dragonplus-electronics/Atom-Iss5-V001/KiCad/Power.kicad_sch

## KiCad design KiCad/Power.kicad_sch (2024-11-30)

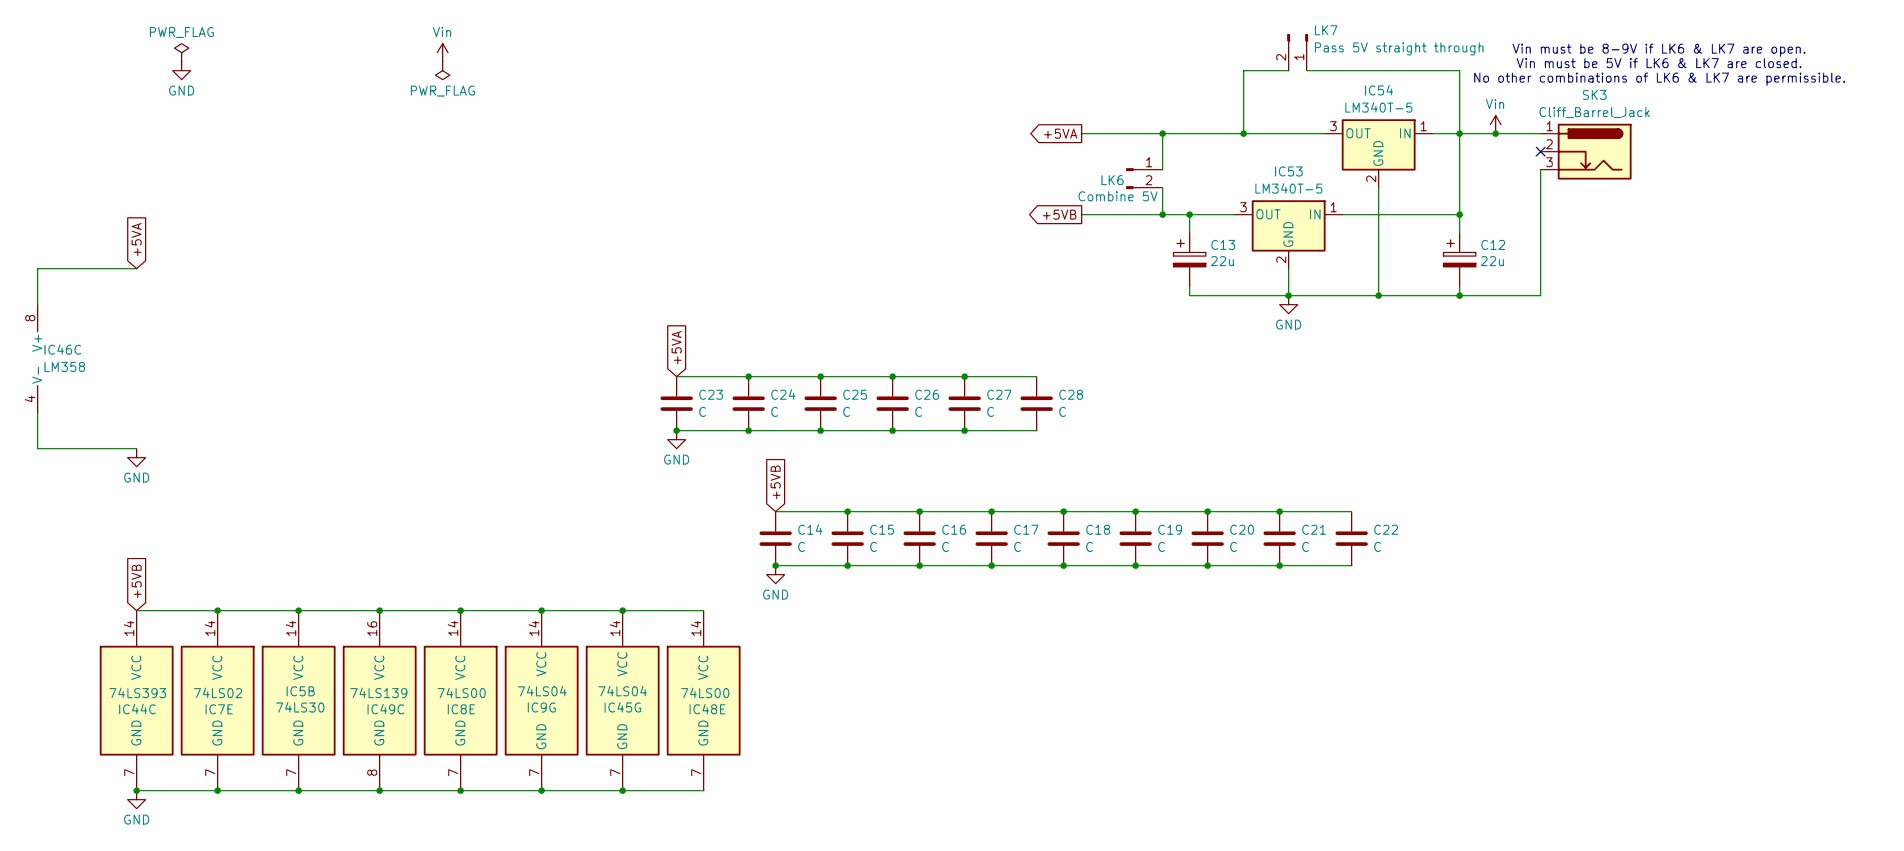
[picture p4: schematic Power.kicad_sch]

Parts:
C12: 22u; CP_Axial_LineOnly_P17.78mm_Horizontal
C13: 22u; CP_Axial_LineOnly_P19.05mm_Horizontal
C14, C15, C16, C17, C18, C19, C20, C21, C22, C23, C24, C25, C26, C27, C28: C; C_Disc_LineOnly_P5.08mm
IC5: 74LS30; DIP-14_W7.62mm_InnerMarking
IC7: 74LS02; DIP-14_W7.62mm_InnerMarking
IC8, IC48: 74LS00; DIP-14_W7.62mm_InnerMarking
IC9, IC45: 74LS04; DIP-14_W7.62mm_InnerMarking
IC44: 74LS393; DIP-14_W7.62mm_InnerMarking
IC46: LM358; DIP-8_W7.62mm_InnerMarking
IC49: 74LS139; DIP-16_W7.62mm_InnerMarking
IC53, IC54: LM340T-5; TO-220-3_Horizontal_TabDown
LK6: Combine 5V; PinHeader_1x02_P2.54mm_Vertical
LK7: Pass 5V straight through; PinHeader_1x02_P2.54mm_Vertical
SK3: Cliff_Barrel_Jack; Cliff_FC681461_Barrel_Jack

Connections:
+5VA: C23.1, C24.1, C25.1, C26.1, C27.1, C28.1, IC46.8 (V+), IC54.3 (OUT), LK6.1, LK7.2
+5VB: C13.1, C14.1, C15.1, C16.1, C17.1, C18.1, C19.1, C20.1, C21.1, C22.1, IC5.14 (VCC), IC7.14 (VCC), IC8.14 (VCC), IC9.14 (VCC), IC44.14 (VCC), IC45.14 (VCC), IC48.14 (VCC), IC49.16 (VCC), IC53.3 (OUT), LK6.2
GND: C12.2, C13.2, C14.2, C15.2, C16.2, C17.2, C18.2, C19.2, C20.2, C21.2, C22.2, C23.2, C24.2, C25.2, C26.2, C27.2, C28.2, IC5.7 (GND), IC7.7 (GND), IC8.7 (GND), IC9.7 (GND), IC44.7 (GND), IC45.7 (GND), IC46.4 (V-), IC48.7 (GND), IC49.8 (GND), IC53.2 (GND), IC54.2 (GND), SK3.3
Vin: C12.1, IC53.1 (IN), IC54.1 (IN), LK7.1, SK3.1

Notes on the sheet:
Vin must be 8-9V if LK6 & LK7 are open. Vin must be 5V if LK6 & LK7 are closed. No other combinations of LK6 & LK7 are permissible.
