dragonplus-electronics/Atom-Iss5-V001/KiCad/keybd.kicad_sch

## KiCad design KiCad/keybd.kicad_sch (2024-11-30)

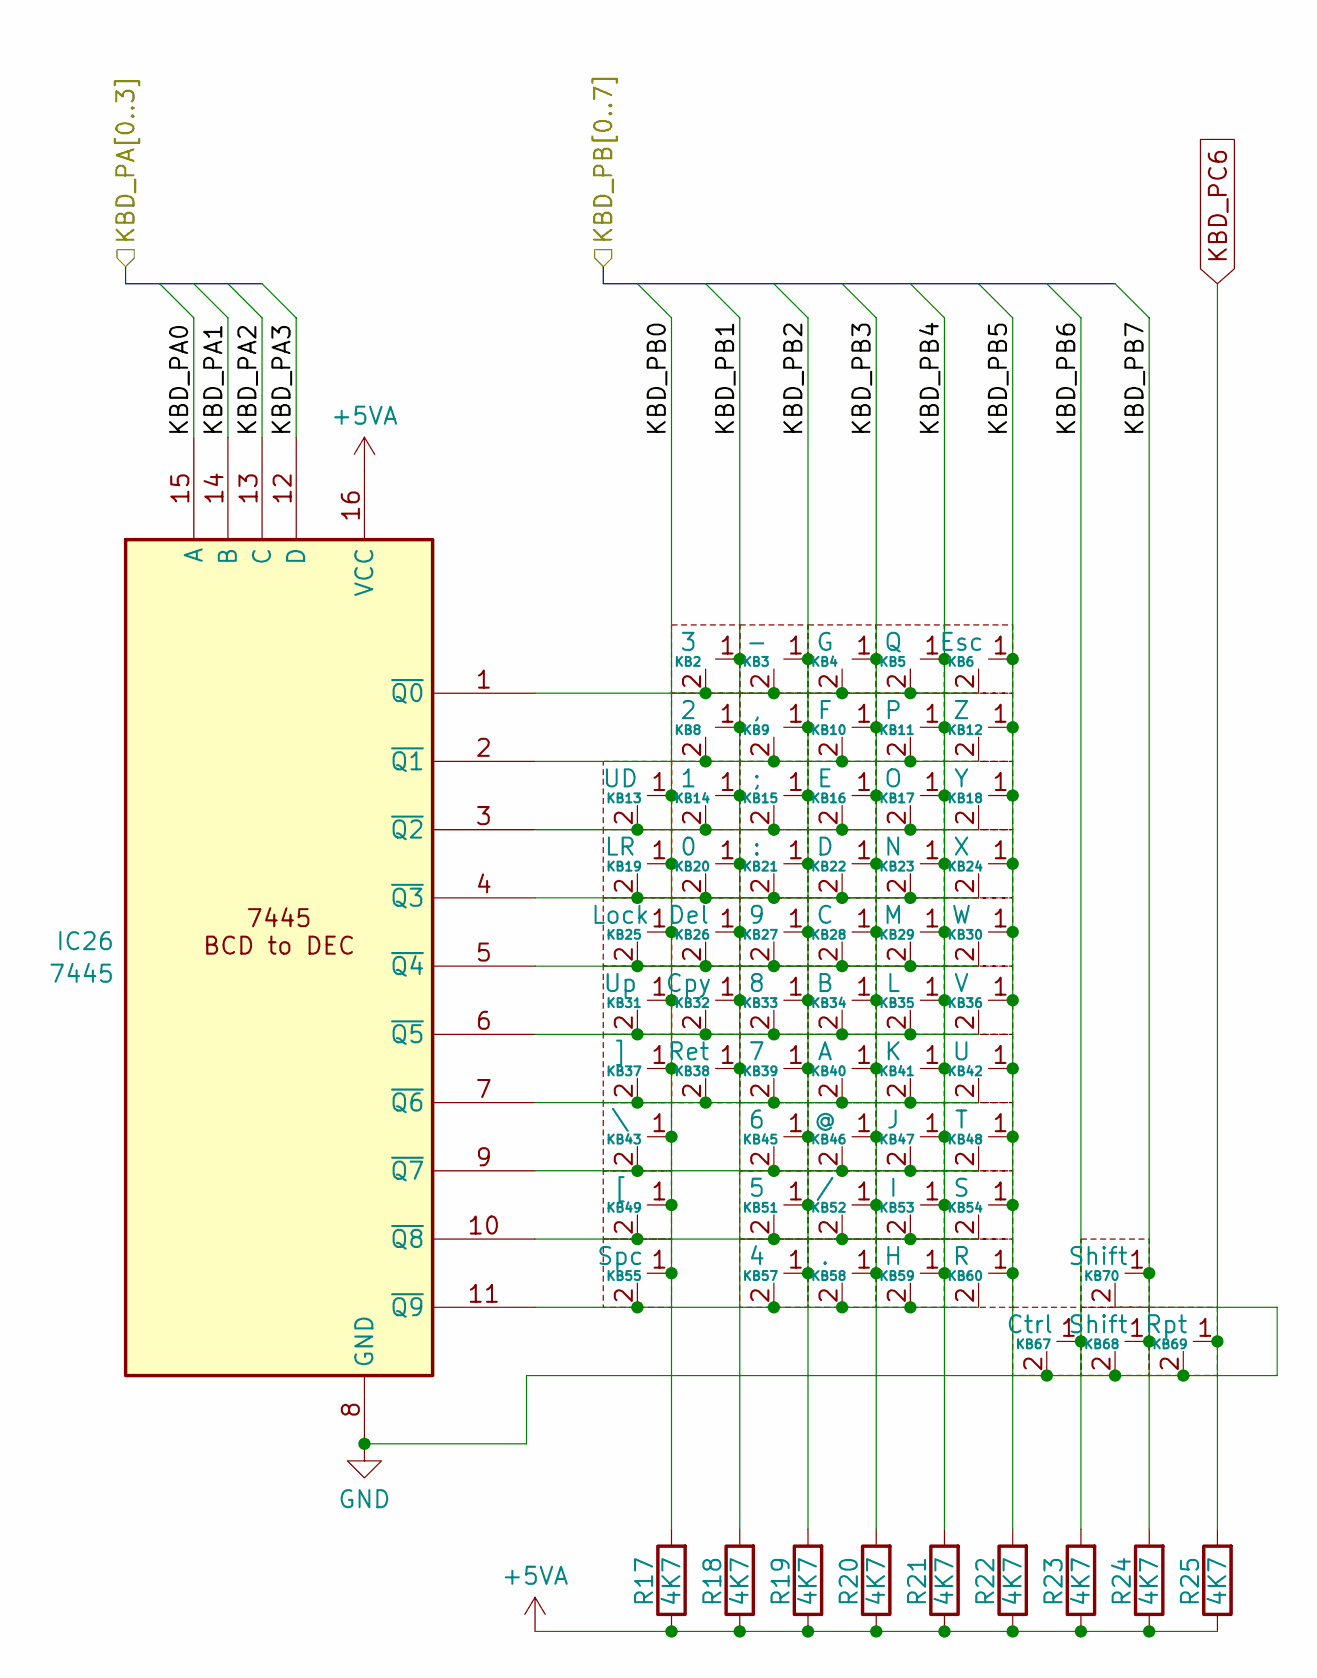
[picture p5: schematic keybd.kicad_sch]

Parts:
IC26: 7445; DIP-16_W7.62mm_InnerMarking
KB2: 3; AtomKeyswitch
KB3: -; AtomKeyswitch
KB4: G; AtomKeyswitch
KB5: Q; AtomKeyswitch
KB6: Esc; AtomKeyswitch
KB8: 2; AtomKeyswitch
KB9: ,; AtomKeyswitch
KB10: F; AtomKeyswitch
KB11: P; AtomKeyswitch
KB12: Z; AtomKeyswitch
KB13: UD; AtomKeyswitch
KB14: 1; AtomKeyswitch
KB15: ;; AtomKeyswitch
KB16: E; AtomKeyswitch
KB17: O; AtomKeyswitch
KB18: Y; AtomKeyswitch
KB19: LR; AtomKeyswitch
KB20: 0; AtomKeyswitch
KB21: :; AtomKeyswitch
KB22: D; AtomKeyswitch
KB23: N; AtomKeyswitch
KB24: X; AtomKeyswitch
KB25: Lock; AtomKeyswitch
KB26: Del; AtomKeyswitch
KB27: 9; AtomKeyswitch
KB28: C; AtomKeyswitch
KB29: M; AtomKeyswitch
KB30: W; AtomKeyswitch
KB31: Up; AtomKeyswitch
KB32: Cpy; AtomKeyswitch
KB33: 8; AtomKeyswitch
KB34: B; AtomKeyswitch
KB35: L; AtomKeyswitch
KB36: V; AtomKeyswitch
KB37: ]; AtomKeyswitch
KB38: Ret; AtomKeyswitch
KB39: 7; AtomKeyswitch
KB40: A; AtomKeyswitch
KB41: K; AtomKeyswitch
KB42: U; AtomKeyswitch
KB43: \; AtomKeyswitch
KB45: 6; AtomKeyswitch
KB46: @; AtomKeyswitch
KB47: J; AtomKeyswitch
KB48: T; AtomKeyswitch
KB49: [; AtomKeyswitch
KB51: 5; AtomKeyswitch
KB52: /; AtomKeyswitch
KB53: I; AtomKeyswitch
KB54: S; AtomKeyswitch
KB55: Spc; AtomKeyswitch
KB57: 4; AtomKeyswitch
KB58: .; AtomKeyswitch
KB59: H; AtomKeyswitch
KB60: R; AtomKeyswitch
KB67: Ctrl; AtomKeyswitch
KB68, KB70: Shift; AtomKeyswitch
KB69: Rpt; AtomKeyswitch
R17, R18: 4K7; R_Axial_DIN0207_LineOnly_P5.08mm_Vertical
R19, R25: 4K7; R_Axial_DIN0207_LineOnly_P4.00mm_Vertical
R20, R21, R22, R23, R24: 4K7; R_Axial_DIN0207_LineOnly_P2.54mm_Vertical

Connections:
+5VA: IC26.16 (VCC), R17.1, R18.1, R19.1, R20.1, R21.1, R22.1, R23.1, R24.1, R25.1
GND: IC26.8 (GND), KB67.2, KB68.2, KB69.2, KB70.2
KBD_PA0: IC26.15 (A)
KBD_PA1: IC26.14 (B)
KBD_PA2: IC26.13 (C)
KBD_PA3: IC26.12 (D)
KBD_PB0: KB13.1, KB19.1, KB25.1, KB31.1, KB37.1, KB43.1, KB49.1, KB55.1, R17.2
KBD_PB1: KB2.1, KB8.1, KB14.1, KB20.1, KB26.1, KB32.1, KB38.1, R18.2
KBD_PB2: KB3.1, KB9.1, KB15.1, KB21.1, KB27.1, KB33.1, KB39.1, KB45.1, KB51.1, KB57.1, R19.2
KBD_PB3: KB4.1, KB10.1, KB16.1, KB22.1, KB28.1, KB34.1, KB40.1, KB46.1, KB52.1, KB58.1, R20.2
KBD_PB4: KB5.1, KB11.1, KB17.1, KB23.1, KB29.1, KB35.1, KB41.1, KB47.1, KB53.1, KB59.1, R21.2
KBD_PB5: KB6.1, KB12.1, KB18.1, KB24.1, KB30.1, KB36.1, KB42.1, KB48.1, KB54.1, KB60.1, R22.2
KBD_PB6: KB67.1, R23.2
KBD_PB7: KB68.1, KB70.1, R24.2
KBD_PC6: KB69.1, R25.2
unnamed: IC26.1 (~Q0), KB2.2, KB3.2, KB4.2, KB5.2, KB6.2
unnamed: IC26.2 (~Q1), KB8.2, KB9.2, KB10.2, KB11.2, KB12.2
unnamed: IC26.3 (~Q2), KB13.2, KB14.2, KB15.2, KB16.2, KB17.2, KB18.2
unnamed: IC26.4 (~Q3), KB19.2, KB20.2, KB21.2, KB22.2, KB23.2, KB24.2
unnamed: IC26.5 (~Q4), KB25.2, KB26.2, KB27.2, KB28.2, KB29.2, KB30.2
unnamed: IC26.6 (~Q5), KB31.2, KB32.2, KB33.2, KB34.2, KB35.2, KB36.2
unnamed: IC26.7 (~Q6), KB37.2, KB38.2, KB39.2, KB40.2, KB41.2, KB42.2
unnamed: IC26.9 (~Q7), KB43.2, KB45.2, KB46.2, KB47.2, KB48.2
unnamed: IC26.10 (~Q8), KB49.2, KB51.2, KB52.2, KB53.2, KB54.2
unnamed: IC26.11 (~Q9), KB55.2, KB57.2, KB58.2, KB59.2, KB60.2
