dragonplus-electronics/Atom-Iss5-V001/KiCad/video.kicad_sch

## KiCad design KiCad/video.kicad_sch (2024-11-30)

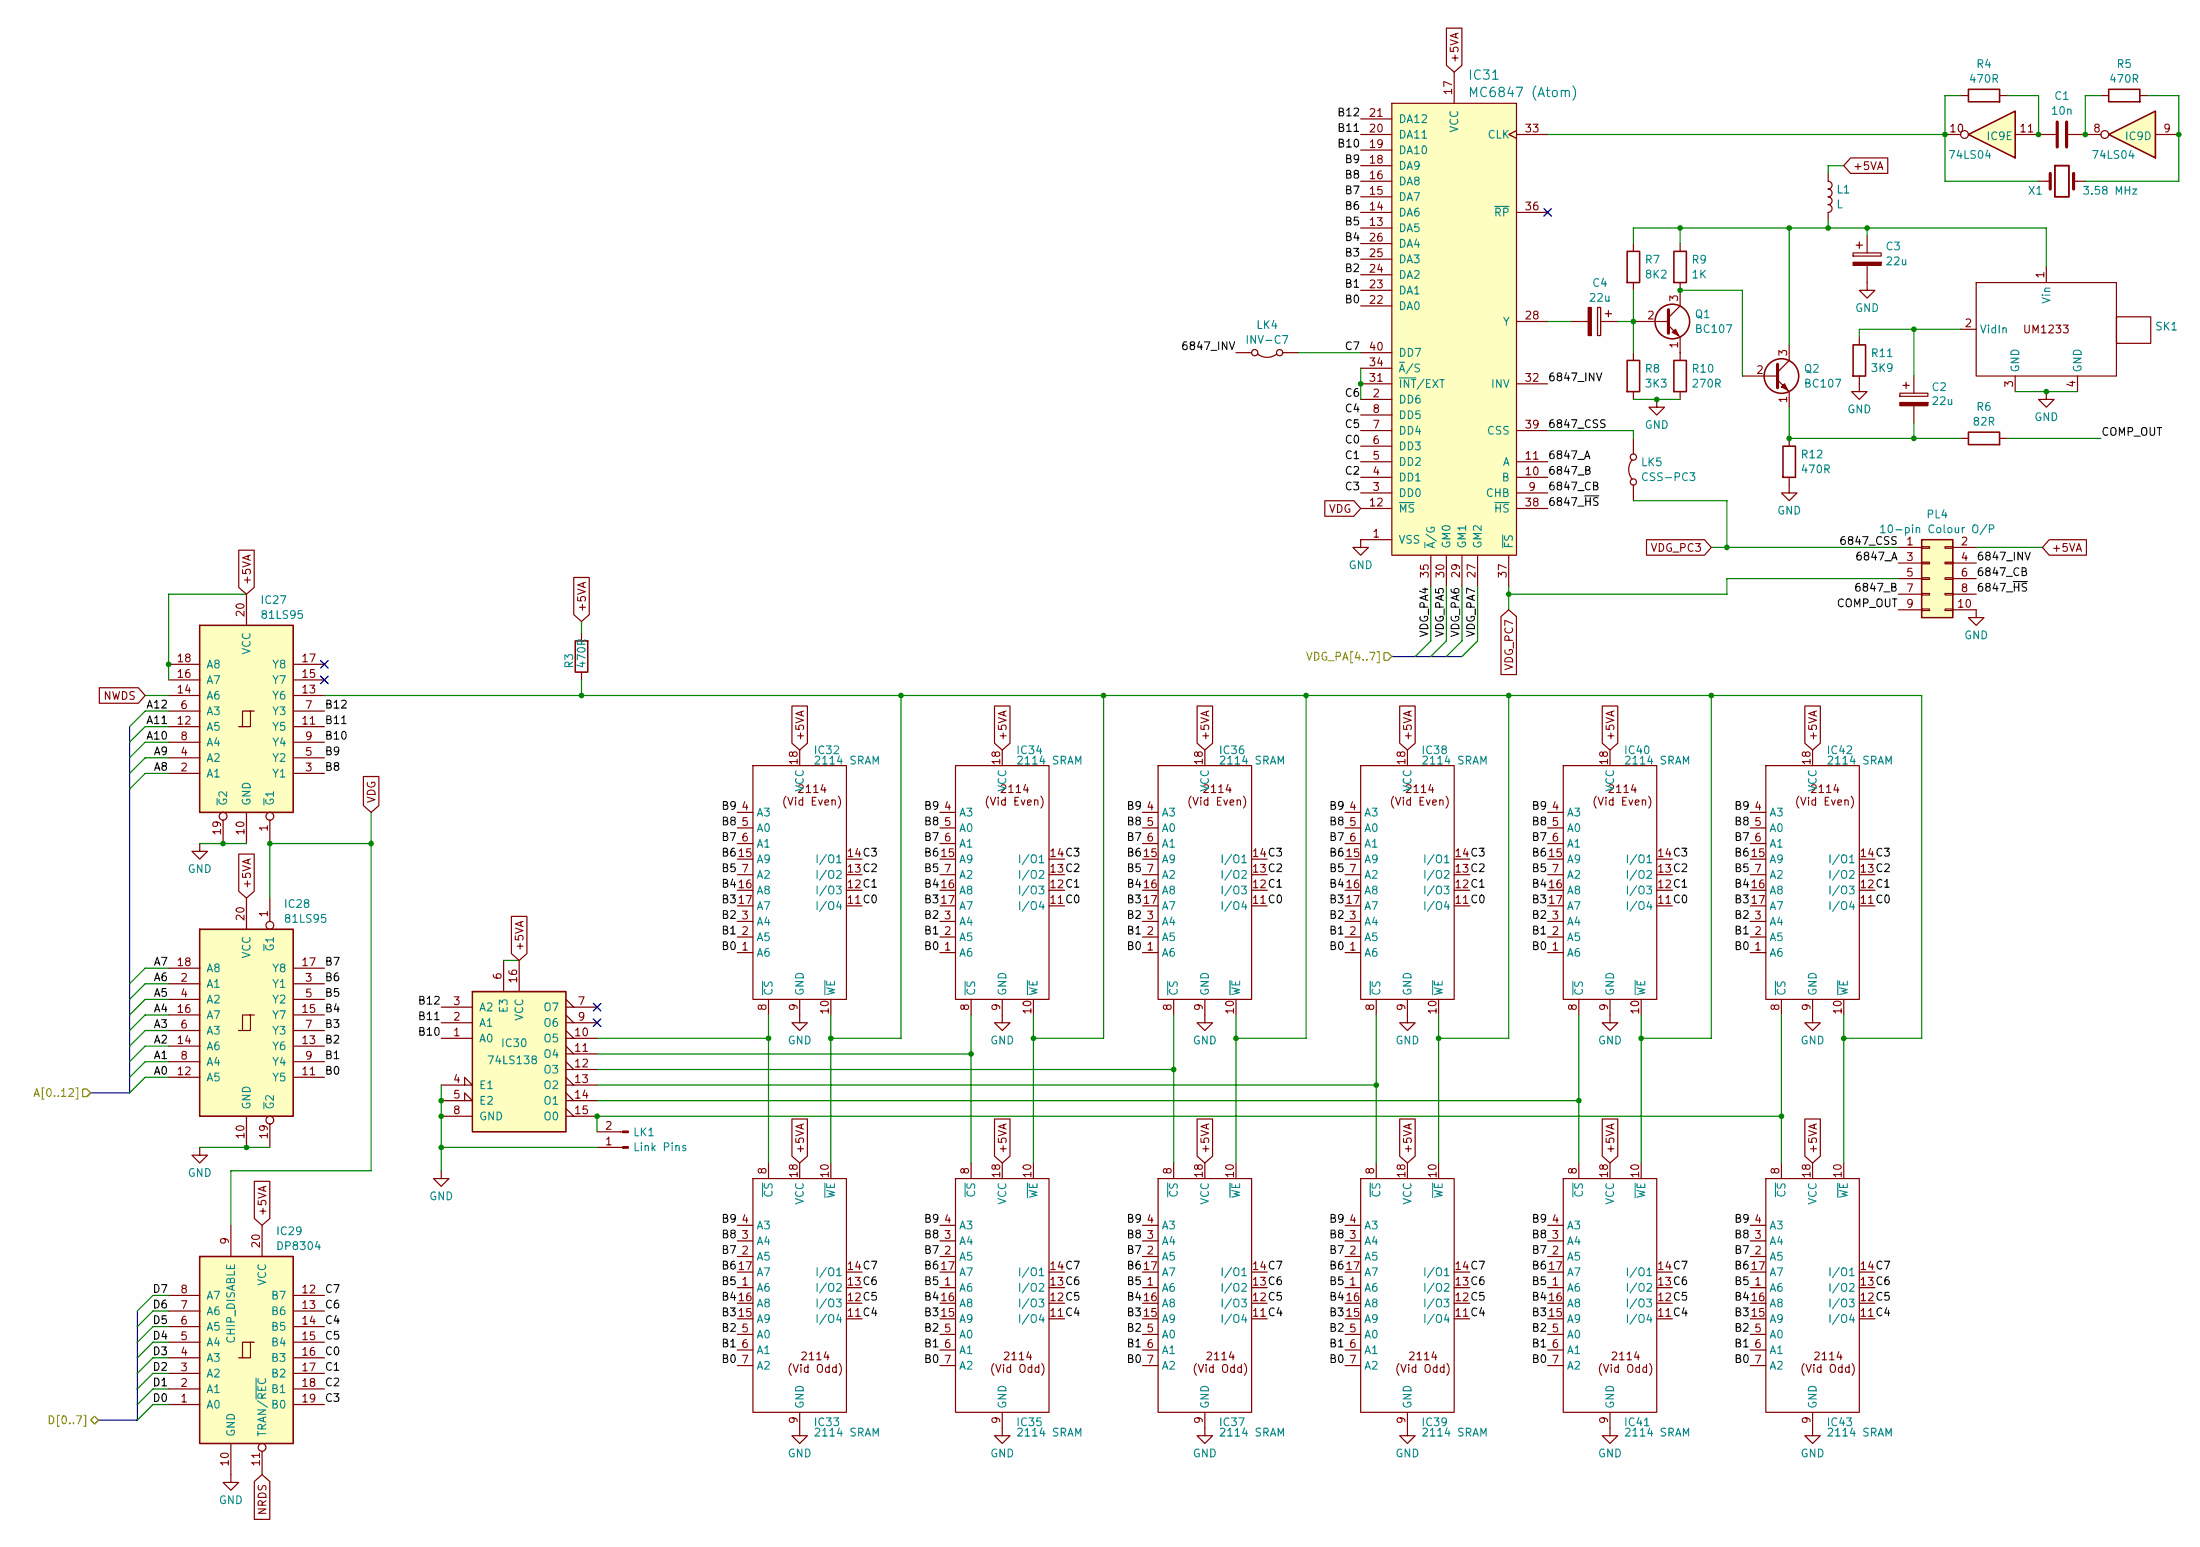
[picture p6: schematic video.kicad_sch]

Parts:
C1: 10n; C_Disc_LineOnly_P10.16mm
C2, C3: 22u; CP_Axial_LineOnly_P17.78mm_Horizontal
C4: 22u; CP_Axial_LineOnly_P15.24mm_Horizontal
IC9: 74LS04; DIP-14_W7.62mm_InnerMarking
IC27, IC28: 81LS95; DIP-20_W7.62mm_InnerMarking
IC29: DP8304; DIP-20_W7.62mm_InnerMarking
IC30: 74LS138; DIP-16_W7.62mm_InnerMarking
IC31: MC6847 (Atom); DIP-40_W15.24mm_InnerMarking
IC32, IC33, IC34, IC35, IC36, IC37, IC38, IC39, IC40, IC41, IC42, IC43: 2114 SRAM; DIP-18_W7.62mm_InnerMarking
L1: L; L_Axial_L7.0mm_D3.3mm_P5.08mm_Vertical_Fastron_MICC
LK1: Link Pins; PinHeader_1x02_P2.54mm_Vertical
LK4: INV-C7; SolderJumper-2_P1.3mm_Bridged_Pad1.0x1.5mm
LK5: CSS-PC3; SolderJumper-2_P1.3mm_Bridged_Pad1.0x1.5mm
PL4: 10-pin Colour O/P; PinHeader_2x05_P2.54mm_Vertical
Q1, Q2: BC107; TO-18-3_WidePinout
R3, R5: 470R; R_Axial_DIN0207_LineOnly_P2.54mm_Vertical
R4, R12: 470R; R_Axial_DIN0207_LineOnly_P10.16mm_Horizontal
R6: 82R; R_Axial_DIN0207_LineOnly_P10.16mm_Horizontal
R7: 8K2; R_Axial_DIN0207_LineOnly_P10.16mm_Horizontal
R8: 3K3; R_Axial_DIN0207_LineOnly_P10.16mm_Horizontal
R9: 1K; R_Axial_DIN0207_LineOnly_P10.16mm_Horizontal
R10: 270R; R_Axial_DIN0207_LineOnly_P10.16mm_Horizontal
R11: 3K9; R_Axial_DIN0207_LineOnly_P10.16mm_Horizontal
SK1: UM1233
X1: 3.58 MHz; C_Disc_LineOnly_P10.16mm

Connections:
6847_A: IC31.11 (A), PL4.3
6847_B: IC31.10 (B), PL4.7
6847_CB: IC31.9 (CHB), PL4.6
6847_INV: IC31.32 (INV), LK4.2 (B), PL4.4
6847_~HS: IC31.38 (~HS), PL4.8
+5VA: IC27.16 (A7), IC27.18 (A8), IC27.20 (VCC), IC28.20 (VCC), IC29.20 (VCC), IC30.6 (E3), IC30.16 (VCC), IC31.17 (VCC), IC32.18 (VCC), IC33.18 (VCC), IC34.18 (VCC), IC35.18 (VCC), IC36.18 (VCC), IC37.18 (VCC), IC38.18 (VCC), IC39.18 (VCC), IC40.18 (VCC), IC41.18 (VCC), IC42.18 (VCC), IC43.18 (VCC), L1.1, PL4.2, R3.2
A0: IC28.12 (A5)
A1: IC28.8 (A4)
A2: IC28.14 (A6)
A3: IC28.6 (A3)
A4: IC28.16 (A7)
A5: IC28.4 (A2)
A6: IC28.2 (A1)
A7: IC28.18 (A8)
A8: IC27.2 (A1)
A9: IC27.4 (A2)
A10: IC27.8 (A4)
A11: IC27.12 (A5)
A12: IC27.6 (A3)
B0: IC28.11 (Y5), IC31.22 (DA0), IC32.1 (A6), IC33.7 (A2), IC34.1 (A6), IC35.7 (A2), IC36.1 (A6), IC37.7 (A2), IC38.1 (A6), IC39.7 (A2), IC40.1 (A6), IC41.7 (A2), IC42.1 (A6), IC43.7 (A2)
B1: IC28.9 (Y4), IC31.23 (DA1), IC32.2 (A5), IC33.6 (A1), IC34.2 (A5), IC35.6 (A1), IC36.2 (A5), IC37.6 (A1), IC38.2 (A5), IC39.6 (A1), IC40.2 (A5), IC41.6 (A1), IC42.2 (A5), IC43.6 (A1)
B2: IC28.13 (Y6), IC31.24 (DA2), IC32.3 (A4), IC33.5 (A0), IC34.3 (A4), IC35.5 (A0), IC36.3 (A4), IC37.5 (A0), IC38.3 (A4), IC39.5 (A0), IC40.3 (A4), IC41.5 (A0), IC42.3 (A4), IC43.5 (A0)
B3: IC28.7 (Y3), IC31.25 (DA3), IC32.17 (A7), IC33.15 (A9), IC34.17 (A7), IC35.15 (A9), IC36.17 (A7), IC37.15 (A9), IC38.17 (A7), IC39.15 (A9), IC40.17 (A7), IC41.15 (A9), IC42.17 (A7), IC43.15 (A9)
B4: IC28.15 (Y7), IC31.26 (DA4), IC32.16 (A8), IC33.16 (A8), IC34.16 (A8), IC35.16 (A8), IC36.16 (A8), IC37.16 (A8), IC38.16 (A8), IC39.16 (A8), IC40.16 (A8), IC41.16 (A8), IC42.16 (A8), IC43.16 (A8)
B5: IC28.5 (Y2), IC31.13 (DA5), IC32.7 (A2), IC33.1 (A6), IC34.7 (A2), IC35.1 (A6), IC36.7 (A2), IC37.1 (A6), IC38.7 (A2), IC39.1 (A6), IC40.7 (A2), IC41.1 (A6), IC42.7 (A2), IC43.1 (A6)
B6: IC28.3 (Y1), IC31.14 (DA6), IC32.15 (A9), IC33.17 (A7), IC34.15 (A9), IC35.17 (A7), IC36.15 (A9), IC37.17 (A7), IC38.15 (A9), IC39.17 (A7), IC40.15 (A9), IC41.17 (A7), IC42.15 (A9), IC43.17 (A7)
B7: IC28.17 (Y8), IC31.15 (DA7), IC32.6 (A1), IC33.2 (A5), IC34.6 (A1), IC35.2 (A5), IC36.6 (A1), IC37.2 (A5), IC38.6 (A1), IC39.2 (A5), IC40.6 (A1), IC41.2 (A5), IC42.6 (A1), IC43.2 (A5)
B8: IC27.3 (Y1), IC31.16 (DA8), IC32.5 (A0), IC33.3 (A4), IC34.5 (A0), IC35.3 (A4), IC36.5 (A0), IC37.3 (A4), IC38.5 (A0), IC39.3 (A4), IC40.5 (A0), IC41.3 (A4), IC42.5 (A0), IC43.3 (A4)
B9: IC27.5 (Y2), IC31.18 (DA9), IC32.4 (A3), IC33.4 (A3), IC34.4 (A3), IC35.4 (A3), IC36.4 (A3), IC37.4 (A3), IC38.4 (A3), IC39.4 (A3), IC40.4 (A3), IC41.4 (A3), IC42.4 (A3), IC43.4 (A3)
B10: IC27.9 (Y4), IC30.1 (A0), IC31.19 (DA10)
B11: IC27.11 (Y5), IC30.2 (A1), IC31.20 (DA11)
B12: IC27.7 (Y3), IC30.3 (A2), IC31.21 (DA12)
C0: IC29.16 (B3), IC31.6 (DD3), IC32.11 (I/O4), IC34.11 (I/O4), IC36.11 (I/O4), IC38.11 (I/O4), IC40.11 (I/O4), IC42.11 (I/O4)
C1: IC29.17 (B2), IC31.5 (DD2), IC32.12 (I/O3), IC34.12 (I/O3), IC36.12 (I/O3), IC38.12 (I/O3), IC40.12 (I/O3), IC42.12 (I/O3)
C2: IC29.18 (B1), IC31.4 (DD1), IC32.13 (I/O2), IC34.13 (I/O2), IC36.13 (I/O2), IC38.13 (I/O2), IC40.13 (I/O2), IC42.13 (I/O2)
C3: IC29.19 (B0), IC31.3 (DD0), IC32.14 (I/O1), IC34.14 (I/O1), IC36.14 (I/O1), IC38.14 (I/O1), IC40.14 (I/O1), IC42.14 (I/O1)
C4: IC29.14 (B5), IC31.8 (DD5), IC33.11 (I/O4), IC35.11 (I/O4), IC37.11 (I/O4), IC39.11 (I/O4), IC41.11 (I/O4), IC43.11 (I/O4)
C5: IC29.15 (B4), IC31.7 (DD4), IC33.12 (I/O3), IC35.12 (I/O3), IC37.12 (I/O3), IC39.12 (I/O3), IC41.12 (I/O3), IC43.12 (I/O3)
C6: IC29.13 (B6), IC31.2 (DD6), IC31.31 (~INT/EXT), IC31.34 (~A/S), IC33.13 (I/O2), IC35.13 (I/O2), IC37.13 (I/O2), IC39.13 (I/O2), IC41.13 (I/O2), IC43.13 (I/O2)
C7: IC29.12 (B7), IC31.40 (DD7), IC33.14 (I/O1), IC35.14 (I/O1), IC37.14 (I/O1), IC39.14 (I/O1), IC41.14 (I/O1), IC43.14 (I/O1), LK4.1 (A)
COMP_OUT: PL4.9, R6.2
D0: IC29.1 (A0)
D1: IC29.2 (A1)
D2: IC29.3 (A2)
D3: IC29.4 (A3)
D4: IC29.5 (A4)
D5: IC29.6 (A5)
D6: IC29.7 (A6)
D7: IC29.8 (A7)
GND: C3.2, IC27.10 (GND), IC27.19 (~G2), IC28.10 (GND), IC28.19 (~G2), IC29.10 (GND), IC30.4 (E1), IC30.5 (E2), IC30.8 (GND), IC31.1 (VSS), IC32.9 (GND), IC33.9 (GND), IC34.9 (GND), IC35.9 (GND), IC36.9 (GND), IC37.9 (GND), IC38.9 (GND), IC39.9 (GND), IC40.9 (GND), IC41.9 (GND), IC42.9 (GND), IC43.9 (GND), LK1.1, PL4.10, R8.2, R10.2, R11.2, R12.2, SK1.3 (GND), SK1.4 (GND)
NRDS: IC29.11 (TRAN/~REC)
NWDS: IC27.14 (A6)
unnamed: C1.1, IC9.11, R4.2
unnamed: C1.2, IC9.8, R5.1
unnamed: C2.1, R11.1, SK1.2 (VidIn)
unnamed: C2.2, Q2.1 (E), R6.1, R12.1
unnamed: C3.1, L1.2, Q2.3 (C), R7.1, R9.1, SK1.1 (Vin)
unnamed: C4.1, Q1.2 (B), R7.2, R8.1
unnamed: C4.2, IC31.28 (Y)
unnamed: IC9.9, R5.2, X1.2
unnamed: IC27.13 (Y6), IC32.10 (~WE), IC33.10 (~WE), IC34.10 (~WE), IC35.10 (~WE), IC36.10 (~WE), IC37.10 (~WE), IC38.10 (~WE), IC39.10 (~WE), IC40.10 (~WE), IC41.10 (~WE), IC42.10 (~WE), IC43.10 (~WE), R3.1
unnamed: IC30.10 (O5), IC32.8 (~CS), IC33.8 (~CS)
unnamed: IC30.11 (O4), IC34.8 (~CS), IC35.8 (~CS)
unnamed: IC30.12 (O3), IC36.8 (~CS), IC37.8 (~CS)
unnamed: IC30.13 (O2), IC38.8 (~CS), IC39.8 (~CS)
unnamed: IC30.14 (O1), IC40.8 (~CS), IC41.8 (~CS)
unnamed: IC30.15 (O0), IC42.8 (~CS), IC43.8 (~CS), LK1.2
unnamed: IC9.10, IC31.33 (CLK), R4.1, X1.1
unnamed: Q1.1 (E), R10.1
unnamed: Q1.3 (C), Q2.2 (B), R9.2
VDG: IC27.1 (~G1), IC28.1 (~G1), IC29.9 (CHIP_DISABLE), IC31.12 (~MS)
VDG_PA4: IC31.35 (~A/G)
VDG_PA5: IC31.30 (GM0)
VDG_PA6: IC31.29 (GM1)
VDG_PA7: IC31.27 (GM2)
VDG_PC3: IC31.39 (CSS), LK5.1 (A), LK5.2 (B), PL4.1
VDG_PC7: IC31.37 (~FS), PL4.5
