dragonplus-electronics/Atom-Iss5-V001/(commit log)

2024-11-30 Add KiCad Files
    [AtomV5Board-B_Cu.gbr, AtomV5Board-B_Mask.gbr, AtomV5Board-B_Paste.gbr, AtomV5Board-B_Silkscreen.gbr, AtomV5Board-Edge_Cuts.gbr, AtomV5Board-F_Cu.gbr, AtomV5Board-F_Mask.gbr, AtomV5Board-F_Paste.gbr]
2024-11-30 Update Gerbers
    [AtomV5Board-B_Cu.gbr, AtomV5Board-B_Mask.gbr, AtomV5Board-B_Paste.gbr, AtomV5Board-B_Silkscreen.gbr, AtomV5Board-Edge_Cuts.gbr, AtomV5Board-F_Cu.gbr, AtomV5Board-F_Mask.gbr, AtomV5Board-F_Paste.gbr]
